theps07/midiTheremin/README.md

# MIDI Theremin
A MIDI class compliant device that captures and converts hand gestures into MIDI notes and control changes.
[Working Demo/Overview](https://www.youtube.com/watch?v=GBBQPvM9b_o&list=PLEQw60v5d5Rrh2Cg-ZqJHufsg2zAsitwK&index=5)
